Happsson/Morebac/(list of files, drawings)

Other design files:
Diptrace/MOREBAC.dch
Diptrace/MOREBAC.dip
