Happsson/Morebac/STM32-Project/Morbac.ioc

Mcu.UserName=STM32L053R6Tx
PA0.Signal=ADC_IN0
PA1.Signal=ADC_IN1
PA10.Signal=USART1_RX
PA11.Signal=GPIO_Output
PA12.Signal=GPIO_Output
PA13.Signal=SYS_SWDIO
PA14.Signal=SYS_SWCLK
PA15.Signal=GPIO_Output
PA2.Signal=ADC_IN2
PA3.Signal=ADC_IN3
PA4.Signal=ADC_IN4
PA5.Signal=ADC_IN5
PA6.Signal=ADC_IN6
PA7.Signal=ADC_IN7
PA8.Signal=GPIO_Output
PA9.Signal=USART1_TX
PB0.Signal=ADC_IN8
PB1.Signal=ADC_IN9
PB10.Signal=GPIO_Output
PB11.Signal=GPIO_Output
PB12.Signal=GPIO_Output
PB13.Signal=GPIO_Output
PB14.Signal=GPIO_Output
PB15.Signal=GPIO_Output
PB2.Signal=GPIO_Output
PB3.Signal=GPIO_Output
PB4.Signal=GPIO_Output
PB5.Signal=GPIO_Output
PB6.Signal=I2C1_SCL
PB7.Signal=I2C1_SDA
PC0.Signal=ADC_IN10
PC1.Signal=ADC_IN11
PC10.Signal=GPIO_Output
PC11.Signal=GPIO_Output
PC12.Signal=GPIO_Output
PC13.Signal=GPIO_Output
PC2.Signal=ADC_IN12
PC3.Signal=ADC_IN13
PC4.Signal=ADC_IN14
PC5.Signal=ADC_IN15
PC6.Signal=GPIO_Output
PC7.Signal=GPIO_Output
PC8.Signal=GPIO_Output
PC9.Signal=GPIO_Output
PD2.Signal=GPIO_Output
